ktec-hq/ErgoDone/pro_micro_teensy_2.0_comparsion.png

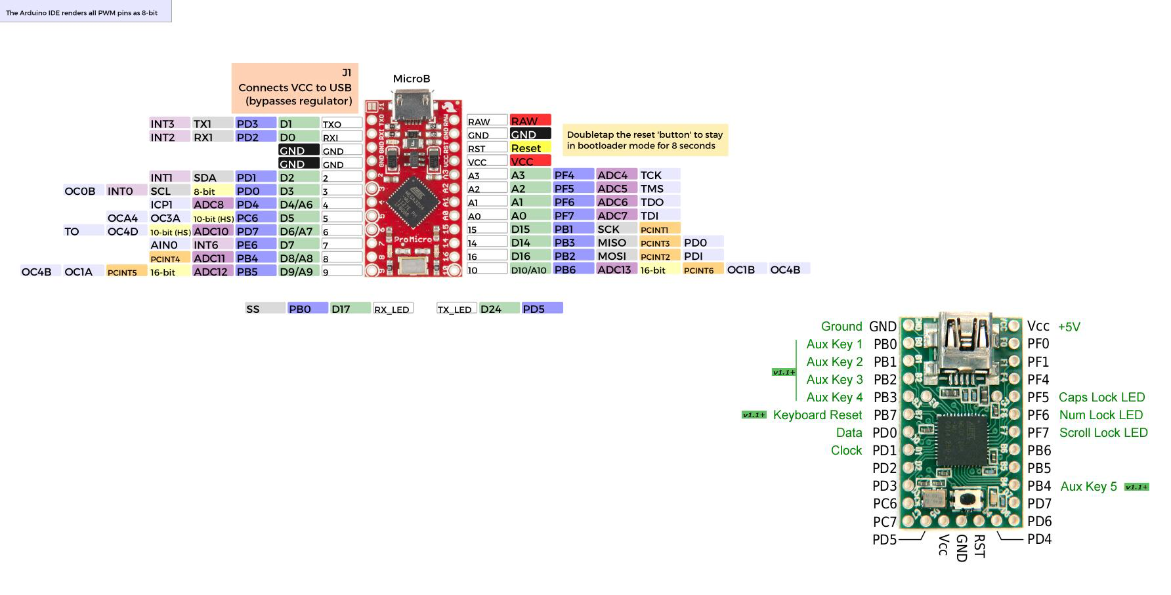
pro_micro_teensy_2.0_comparsion.png
