ktec-hq/ErgoDone/README.md

# ErgoDone

Original work by Dox. K.T.E.C. present.
# Lisence
GPL v3
