ktec-hq/ErgoDone/ErgoDone.sch

## KiCad design ErgoDone.sch (2017-04-09, an earlier design)

Schematic: ErgoDone.sch

Parts:
C1: 0.1uF; C_Rect_L7_W2_P5
D1:7, D1:8: D
H99: MECHANICAL
J1: USB
J2: 3.5mm
J3, J4: JMP
LED_A1: LEDa
LED_B1: LEDb
LED_C1: LEDc
R1, R2: 2.2kΩ
RA1: LEDa
RB1: LEDb
RC1: LEDc
S1, S2: STAB200
SW0:7: SW0:6
SW0:8: SW0:5
SW0:9: SW0:4
SW0:10: SW0:3
SW0:11: SW0:2
SW0:12: SW0:1
SW1:9: SW1:4
SW1:10: SW1:3
SW1:11: SW1:2
SW1:12: SW1:1
SW1:13: SW1:0
SW2:7: SW2:6
SW2:8: SW2:5
SW2:9: SW2:4
SW2:10: SW2:3
SW2:11: SW2:2
SW2:12: SW2:1
SW2:13: SW2:0
SW3:8: SW3:5
SW3:9: SW3:4
SW3:10: SW3:3
SW3:11: SW3:2
SW3:12: SW3:1
SW3:13: SW3:0
SW4:7: SW4:6
SW4:8: SW4:5
SW4:9: SW4:4
SW4:10: SW4:3
SW4:11: SW4:2
SW4:12: SW4:1
SW4:13: SW4:0
SW5:7: SW5:6
SW5:8: SW5:5
SW5:9: SW5:4
SW5:10: SW5:3
SW5:11: SW5:2
SW5:12: SW5:1
SW5:13: SW5:0
SX0:10: SX0:3
SX0:11: SX0:2
SX1:7: SX1:6
SX1:8: SX1:5
U1: ProMicro
U2: MCP23017
