ktec-hq/ErgoDone/(threads)

Thread 2 (2017-10-02):

"Present by K.T.E.C."

marcostrauss, 2017-10-02:
On the right hand PCB it reads:

    Present by K.T.E.C.

This is bad English and can be understood as: 🎁 Gift from K.T.E.C.

Correctly, it would be:

    Presented by K.T.E.C.

But the following should be enough ([proof](https://www.google.com/search?tbm=isch&q=By+Dolce+%26+Gabbana)):

    By K.T.E.C.

Thread 3 (2023-04-13):

gerber update to v1.5?

Original-Dan, 2023-04-13:
hi is it possible to update the gerber to v1.5? i tried opening up the pcb file in kicad and generating plots and such then zipping up the gerbers generated but on pcbway i can't see the traces, never used these kinds of software before so i don't know what I'm doing lol, first time trying to diy an ergo keyboard, thanks.
