ktec-hq/ErgoDone/(commit log)

2016-06-15 Ver 0.1
    [ErgoDOX-B.Mask.gbs, ErgoDOX-B.Paste.gbp, ErgoDOX-B.SilkS.gbo, ErgoDOX-B_Mask.gbs, ErgoDOX-B_SilkS.gbo, ErgoDOX-Back.gbl, ErgoDOX-Edge.Cuts.gm1, ErgoDOX-Edge_Cuts.gbr]
2016-06-15 Change IO Expander to MCP23017. Add a logo
    [ErgoDOX-B.Mask.gbs, ErgoDOX-B.Paste.gbp, ErgoDOX-B.SilkS.gbo, ErgoDOX-Back.gbl, ErgoDOX-Edge.Cuts.gm1, ErgoDOX-F.Mask.gts, ErgoDOX-F.Paste.gtp, ErgoDOX-F.SilkS.gto]
2016-06-15 Add K.T.E.C. icon
    [ErgoDOX-B.Mask.gbs, ErgoDOX-B.Paste.gbp, ErgoDOX-B.SilkS.gbo, ErgoDOX-Back.gbl, ErgoDOX-Edge.Cuts.gm1, ErgoDOX-F.Mask.gts, ErgoDOX-F.Paste.gtp, ErgoDOX-F.SilkS.gto]
2016-06-15 Remove the K.T.E.C logo
    [ErgoDOX-B.Mask.gbs, ErgoDOX-B.Paste.gbp, ErgoDOX-B.SilkS.gbo, ErgoDOX-Back.gbl, ErgoDOX-Edge.Cuts.gm1, ErgoDOX-F.Mask.gts, ErgoDOX-F.Paste.gtp, ErgoDOX-F.SilkS.gto]
2016-06-16 update gerber files
    [ErgoDOX-B.Mask.gbs, ErgoDOX-B.Paste.gbp, ErgoDOX-B.SilkS.gbo, ErgoDOX-Back.gbl, ErgoDOX-Edge.Cuts.gm1, ErgoDOX-F.Mask.gts, ErgoDOX-F.Paste.gtp, ErgoDOX-F.SilkS.gto]
2016-06-16 Update the logo
    [ErgoDOX-B.Mask.gbs, ErgoDOX-B.Paste.gbp, ErgoDOX-B.SilkS.gbo, ErgoDOX-Back.gbl, ErgoDOX-Edge.Cuts.gm1, ErgoDOX-F.Mask.gts, ErgoDOX-F.Paste.gtp, ErgoDOX-F.SilkS.gto]
2016-07-10 Change Micro Pro to left hand
    [ErgoDOX.kicad_pcb, ErgoDOX.sch]
2016-07-10 add 0.1uF capacitor
    [ErgoDOX.kicad_pcb, ErgoDOX.sch]
2016-07-14 fix several bugs
    [ErgoDOX.kicad_pcb]
2016-07-15 ver 1.0
    [ErgoDOX-B.Mask.gbs, ErgoDOX-B.SilkS.gbo, ErgoDOX-Back.gbl, ErgoDOX-Edge.Cuts.gm1, ErgoDOX-F.Mask.gts, ErgoDOX-F.SilkS.gto, ErgoDOX-Front.gtl, ErgoDOX-NPTH.drl]
2016-07-17 update silkscreen
    [ErgoDOX-B.Mask.gbs, ErgoDOX-B.SilkS.gbo, ErgoDOX-Back.gbl, ErgoDOX-Edge.Cuts.gm1, ErgoDOX-F.Mask.gts, ErgoDOX-F.SilkS.gto, ErgoDOX-Front.gtl, ErgoDOX-NPTH.drl]
2016-07-17 Final touches on ver 1.0
    [ErgoDOX-B.Mask.gbs, ErgoDOX-B.SilkS.gbo, ErgoDOX-Back.gbl, ErgoDOX-Edge.Cuts.gm1, ErgoDOX-F.Mask.gts, ErgoDOX-F.SilkS.gto, ErgoDOX-Front.gtl, ErgoDOX-NPTH.drl]
2016-07-18 ver 1.0 redo
    [ErgoDOX-B.Mask.gbr, ErgoDOX-B.SilkS.gbr, ErgoDOX-Back.gbr, ErgoDOX-Edge.Cuts.gbr, ErgoDOX-F.Mask.gbr, ErgoDOX-F.SilkS.gbr, ErgoDOX-Front.gbr, ErgoDOX-NPTH.drl]
2016-07-18 remove old gerber folder
    [ErgoDOX-B.Mask.gbs, ErgoDOX-B.Paste.gbp, ErgoDOX-B.SilkS.gbo, ErgoDOX-Back.gbl, ErgoDOX-Edge.Cuts.gm1, ErgoDOX-F.Mask.gts, ErgoDOX-F.Paste.gtp, ErgoDOX-F.SilkS.gto]
2016-07-19 update drill file
    [ErgoDOX-NPTH.drl, ErgoDOX.drl]
2016-08-19 Fix incorrect 1u spacing (gerber updated)
    [ErgoDOX-B.Mask.gbr, ErgoDOX-B.SilkS.gbr, ErgoDOX-Back.gbr, ErgoDOX-Edge.Cuts.gbr, ErgoDOX-F.Mask.gbr, ErgoDOX-F.SilkS.gbr, ErgoDOX-Front.gbr, ErgoDOX-NPTH.drl]
2016-08-22 Change the location of the capacitor
    [ErgoDOX-B.Mask.gbr, ErgoDOX-B.SilkS.gbr, ErgoDOX-Back.gbr, ErgoDOX-Edge.Cuts.gbr, ErgoDOX-F.Mask.gbr, ErgoDOX-F.SilkS.gbr, ErgoDOX-Front.gbr, ErgoDOX-NPTH.drl]
2016-08-23 update gerber file
    [ErgoDOX-B.Mask.gbr, ErgoDOX-B.SilkS.gbr, ErgoDOX-Back.gbr, ErgoDOX-Edge.Cuts.gbr, ErgoDOX-F.Mask.gbr, ErgoDOX-F.SilkS.gbr, ErgoDOX-Front.gbr, ErgoDOX-NPTH.drl]
2016-08-23 Final touches (probably)
    [ErgoDOX-B.Mask.gbr, ErgoDOX-B.SilkS.gbr, ErgoDOX-Back.gbr, ErgoDOX-Edge.Cuts.gbr, ErgoDOX-F.Mask.gbr, ErgoDOX-F.SilkS.gbr, ErgoDOX-Front.gbr, ErgoDOX-NPTH.drl]
2016-08-23 final touches1
    [ErgoDOX-B.Mask.gbr, ErgoDOX-B.SilkS.gbr, ErgoDOX-Back.gbr, ErgoDOX-Edge.Cuts.gbr, ErgoDOX-F.Mask.gbr, ErgoDOX-F.SilkS.gbr, ErgoDOX-Front.gbr, ErgoDOX-NPTH.drl]
2016-08-24 Change J3 and J4
    [ErgoDOX.kicad_pcb]
2016-08-24 Change version number to 1.1
    [ErgoDOX.kicad_pcb]
2016-08-25 Change pin order of 3.5mm jack
    [ErgoDOX.kicad_pcb, ErgoDOX.sch]
2016-08-25 Generate gerber files
    [ErgoDOX-B.Mask.gbr, ErgoDOX-B.SilkS.gbr, ErgoDOX-Back.gbr, ErgoDOX-Edge.Cuts.gbr, ErgoDOX-F.Mask.gbr, ErgoDOX-F.SilkS.gbr, ErgoDOX-Front.gbr, ErgoDOX-NPTH.drl]
2016-09-05 Change board to v1.2 - Fix copper pours
    [ErgoDOX.kicad_pcb]
2016-09-05 Update gerber files and correct file names
    [ErgoDOX-Back.gbr, ErgoDOX-Front.gbr, ErgoDone-B.Mask.gbr, ErgoDone-B.SilkS.gbr, ErgoDone-Back.gbr, ErgoDone-Edge.Cuts.gbr, ErgoDone-F.Mask.gbr, ErgoDone-F.SilkS.gbr]
2017-03-26 "add ktec.io"
    [ErgoDone.kicad_pcb]
2017-04-09 update to v1.3
    [ErgoDone-B.Mask.gbr, ErgoDone-B.SilkS.gbr, ErgoDone-Back.gbr, ErgoDone-Edge.Cuts.gbr, ErgoDone-F.Mask.gbr, ErgoDone-F.SilkS.gbr, ErgoDone-Front.gbr, ErgoDone-NPTH-drl_map.gbr]
2017-04-17 Improve tracks and diode's silk
    [ErgoDone.kicad_pcb]
2017-04-18 improve tracks
    [ErgoDone.kicad_pcb]
2017-08-15 Ver 1.4, add 8 holes on pcb.
    [ErgoDone.kicad_pcb]
2019-06-25 Update to v1.5
    [ErgoDone.kicad_pcb]
